Lingduhm/TI_motor_Gimbal_System/empty_motor_rebuild_divide_OK/keil/Objects/empty_LP_MSPM0G3507_nortos_keil.htm

# Static Call Graph for image .\Objects\empty_LP_MSPM0G3507_nortos_keil.axf

#<CALLGRAPH># ARM Linker, 6210000: Last Updated: Tue Mar 31 16:03:42 2026

### Maximum Stack Usage = 56 bytes + Unknown(Cycles, Untraceable Function Pointers)

### Call chain for Maximum Stack Depth:

Action_Straight ⇒ go_forward_b

### Mutually Recursive functions

- NMI_Handler ⇒ NMI_Handler
- HardFault_Handler ⇒ HardFault_Handler
- SVC_Handler ⇒ SVC_Handler
- PendSV_Handler ⇒ PendSV_Handler
- SysTick_Handler ⇒ SysTick_Handler

### Function Pointers

- ADC0_IRQHandler from startup_mspm0g350x_uvision.o(.text) referenced from startup_mspm0g350x_uvision.o(RESET)
- ADC1_IRQHandler from startup_mspm0g350x_uvision.o(.text) referenced from startup_mspm0g350x_uvision.o(RESET)
- AES_IRQHandler from startup_mspm0g350x_uvision.o(.text) referenced from startup_mspm0g350x_uvision.o(RESET)
- Action_Straight from sensor_rebuild_02.o(.text.Action_Straight) referenced from sensor_rebuild_02.o(.rodata.Car_FSM_Table)
- Action_TurnLeft_Brake from sensor_rebuild_02.o(.text.Action_TurnLeft_Brake) referenced from sensor_rebuild_02.o(.rodata.Car_FSM_Table)
- Action_TurnLeft_Spin from sensor_rebuild_02.o(.text.Action_TurnLeft_Spin) referenced from sensor_rebuild_02.o(.rodata.Car_FSM_Table)
- Action_TurnLeft_Stop from sensor_rebuild_02.o(.text.Action_TurnLeft_Stop) referenced from sensor_rebuild_02.o(.rodata.Car_FSM_Table)
- CANFD0_IRQHandler from startup_mspm0g350x_uvision.o(.text) referenced from startup_mspm0g350x_uvision.o(RESET)
- DAC0_IRQHandler from startup_mspm0g350x_uvision.o(.text) referenced from startup_mspm0g350x_uvision.o(RESET)
- DMA_IRQHandler from startup_mspm0g350x_uvision.o(.text) referenced from startup_mspm0g350x_uvision.o(RESET)
- GROUP0_IRQHandler from startup_mspm0g350x_uvision.o(.text) referenced from startup_mspm0g350x_uvision.o(RESET)
- GROUP1_IRQHandler from startup_mspm0g350x_uvision.o(.text) referenced from startup_mspm0g350x_uvision.o(RESET)
- HardFault_Handler from startup_mspm0g350x_uvision.o(.text) referenced from startup_mspm0g350x_uvision.o(RESET)
- I2C0_IRQHandler from startup_mspm0g350x_uvision.o(.text) referenced from startup_mspm0g350x_uvision.o(RESET)
- I2C1_IRQHandler from startup_mspm0g350x_uvision.o(.text) referenced from startup_mspm0g350x_uvision.o(RESET)
- NMI_Handler from startup_mspm0g350x_uvision.o(.text) referenced from startup_mspm0g350x_uvision.o(RESET)
- PendSV_Handler from startup_mspm0g350x_uvision.o(.text) referenced from startup_mspm0g350x_uvision.o(RESET)
- RTC_IRQHandler from startup_mspm0g350x_uvision.o(.text) referenced from startup_mspm0g350x_uvision.o(RESET)
- Reset_Handler from startup_mspm0g350x_uvision.o(.text) referenced from startup_mspm0g350x_uvision.o(RESET)
- SPI0_IRQHandler from startup_mspm0g350x_uvision.o(.text) referenced from startup_mspm0g350x_uvision.o(RESET)
- SPI1_IRQHandler from startup_mspm0g350x_uvision.o(.text) referenced from startup_mspm0g350x_uvision.o(RESET)
- SVC_Handler from startup_mspm0g350x_uvision.o(.text) referenced from startup_mspm0g350x_uvision.o(RESET)
- SysTick_Handler from startup_mspm0g350x_uvision.o(.text) referenced from startup_mspm0g350x_uvision.o(RESET)
- TIMA0_IRQHandler from empty.o(.text.TIMA0_IRQHandler) referenced from startup_mspm0g350x_uvision.o(RESET)
- TIMA1_IRQHandler from startup_mspm0g350x_uvision.o(.text) referenced from startup_mspm0g350x_uvision.o(RESET)
- TIMG0_IRQHandler from startup_mspm0g350x_uvision.o(.text) referenced from startup_mspm0g350x_uvision.o(RESET)
- TIMG12_IRQHandler from startup_mspm0g350x_uvision.o(.text) referenced from startup_mspm0g350x_uvision.o(RESET)
- TIMG6_IRQHandler from startup_mspm0g350x_uvision.o(.text) referenced from startup_mspm0g350x_uvision.o(RESET)
- TIMG7_IRQHandler from startup_mspm0g350x_uvision.o(.text) referenced from startup_mspm0g350x_uvision.o(RESET)
- TIMG8_IRQHandler from startup_mspm0g350x_uvision.o(.text) referenced from startup_mspm0g350x_uvision.o(RESET)
- UART0_IRQHandler from empty.o(.text.UART0_IRQHandler) referenced from startup_mspm0g350x_uvision.o(RESET)
- UART1_IRQHandler from startup_mspm0g350x_uvision.o(.text) referenced from startup_mspm0g350x_uvision.o(RESET)
- UART2_IRQHandler from startup_mspm0g350x_uvision.o(.text) referenced from startup_mspm0g350x_uvision.o(RESET)
- UART3_IRQHandler from startup_mspm0g350x_uvision.o(.text) referenced from startup_mspm0g350x_uvision.o(RESET)
- __main from __main.o(!!!main) referenced from startup_mspm0g350x_uvision.o(.text)

### Global Symbols

__main (Thumb, 8 bytes, Stack size 0 bytes, __main.o(!!!main))

[Calls]

- >> __rt_entry
- >> __scatterload

[Address Reference Count : 1]

- startup_mspm0g350x_uvision.o(.text)

__scatterload (Thumb, 0 bytes, Stack size unknown bytes, __scatter.o(!!!scatter))

[Called By]

- >> __main

__scatterload_rt2 (Thumb, 74 bytes, Stack size unknown bytes, __scatter.o(!!!scatter), UNUSED)

[Calls]

- >> __rt_entry

__scatterload_rt2_thumb_only (Thumb, 0 bytes, Stack size unknown bytes, __scatter.o(!!!scatter), UNUSED)

__scatterload_loop (Thumb, 0 bytes, Stack size unknown bytes, __scatter.o(!!!scatter), UNUSED)

__scatterload_null (Thumb, 2 bytes, Stack size unknown bytes, __scatter.o(!!handler_null), UNUSED)

__scatterload_zeroinit (Thumb, 28 bytes, Stack size unknown bytes, __scatter_zi.o(!!handler_zi), UNUSED)

__rt_lib_init (Thumb, 0 bytes, Stack size unknown bytes, libinit.o(.ARM.Collect$$libinit$$00000000))

[Called By]

- >> __rt_entry_li

__rt_lib_init_alloca_1 (Thumb, 0 bytes, Stack size unknown bytes, libinit2.o(.ARM.Collect$$libinit$$00000030))

__rt_lib_init_argv_1 (Thumb, 0 bytes, Stack size unknown bytes, libinit2.o(.ARM.Collect$$libinit$$0000002E))

__rt_lib_init_atexit_1 (Thumb, 0 bytes, Stack size unknown bytes, libinit2.o(.ARM.Collect$$libinit$$0000001D))

__rt_lib_init_clock_1 (Thumb, 0 bytes, Stack size unknown bytes, libinit2.o(.ARM.Collect$$libinit$$00000023))

__rt_lib_init_cpp_1 (Thumb, 0 bytes, Stack size unknown bytes, libinit2.o(.ARM.Collect$$libinit$$00000034))

__rt_lib_init_exceptions_1 (Thumb, 0 bytes, Stack size unknown bytes, libinit2.o(.ARM.Collect$$libinit$$00000032))

__rt_lib_init_fp_1 (Thumb, 0 bytes, Stack size unknown bytes, libinit2.o(.ARM.Collect$$libinit$$00000002))

__rt_lib_init_fp_trap_1 (Thumb, 0 bytes, Stack size unknown bytes, libinit2.o(.ARM.Collect$$libinit$$00000021))

__rt_lib_init_getenv_1 (Thumb, 0 bytes, Stack size unknown bytes, libinit2.o(.ARM.Collect$$libinit$$00000025))

__rt_lib_init_heap_1 (Thumb, 0 bytes, Stack size unknown bytes, libinit2.o(.ARM.Collect$$libinit$$0000000C))

__rt_lib_init_lc_collate_1 (Thumb, 0 bytes, Stack size unknown bytes, libinit2.o(.ARM.Collect$$libinit$$00000013))

__rt_lib_init_lc_ctype_1 (Thumb, 0 bytes, Stack size unknown bytes, libinit2.o(.ARM.Collect$$libinit$$00000015))

__rt_lib_init_lc_monetary_1 (Thumb, 0 bytes, Stack size unknown bytes, libinit2.o(.ARM.Collect$$libinit$$00000017))

__rt_lib_init_lc_numeric_1 (Thumb, 0 bytes, Stack size unknown bytes, libinit2.o(.ARM.Collect$$libinit$$00000019))

__rt_lib_init_lc_time_1 (Thumb, 0 bytes, Stack size unknown bytes, libinit2.o(.ARM.Collect$$libinit$$0000001B))

__rt_lib_init_preinit_1 (Thumb, 0 bytes, Stack size unknown bytes, libinit2.o(.ARM.Collect$$libinit$$00000006))

__rt_lib_init_rand_1 (Thumb, 0 bytes, Stack size unknown bytes, libinit2.o(.ARM.Collect$$libinit$$00000010))

__rt_lib_init_relocate_pie_1 (Thumb, 0 bytes, Stack size unknown bytes, libinit2.o(.ARM.Collect$$libinit$$00000004))

__rt_lib_init_return (Thumb, 0 bytes, Stack size unknown bytes, libinit2.o(.ARM.Collect$$libinit$$00000035))

__rt_lib_init_signal_1 (Thumb, 0 bytes, Stack size unknown bytes, libinit2.o(.ARM.Collect$$libinit$$0000001F))

__rt_lib_init_stdio_1 (Thumb, 0 bytes, Stack size unknown bytes, libinit2.o(.ARM.Collect$$libinit$$00000027))

__rt_lib_init_user_alloc_1 (Thumb, 0 bytes, Stack size unknown bytes, libinit2.o(.ARM.Collect$$libinit$$0000000E))

__rt_lib_shutdown (Thumb, 0 bytes, Stack size unknown bytes, libshutdown.o(.ARM.Collect$$libshutdown$$00000000))

[Called By]

- >> __rt_exit_ls

__rt_lib_shutdown_cpp_1 (Thumb, 0 bytes, Stack size unknown bytes, libshutdown2.o(.ARM.Collect$$libshutdown$$00000002))

__rt_lib_shutdown_fp_trap_1 (Thumb, 0 bytes, Stack size unknown bytes, libshutdown2.o(.ARM.Collect$$libshutdown$$00000007))

__rt_lib_shutdown_heap_1 (Thumb, 0 bytes, Stack size unknown bytes, libshutdown2.o(.ARM.Collect$$libshutdown$$0000000F))

__rt_lib_shutdown_return (Thumb, 0 bytes, Stack size unknown bytes, libshutdown2.o(.ARM.Collect$$libshutdown$$00000010))

__rt_lib_shutdown_signal_1 (Thumb, 0 bytes, Stack size unknown bytes, libshutdown2.o(.ARM.Collect$$libshutdown$$0000000A))

__rt_lib_shutdown_stdio_1 (Thumb, 0 bytes, Stack size unknown bytes, libshutdown2.o(.ARM.Collect$$libshutdown$$00000004))

__rt_lib_shutdown_user_alloc_1 (Thumb, 0 bytes, Stack size unknown bytes, libshutdown2.o(.ARM.Collect$$libshutdown$$0000000C))

__rt_entry (Thumb, 0 bytes, Stack size unknown bytes, __rtentry.o(.ARM.Collect$$rtentry$$00000000))

[Called By]

- >> __main
- >> __scatterload_rt2

__rt_entry_presh_1 (Thumb, 0 bytes, Stack size unknown bytes, __rtentry2.o(.ARM.Collect$$rtentry$$00000002))

__rt_entry_sh (Thumb, 0 bytes, Stack size unknown bytes, __rtentry4.o(.ARM.Collect$$rtentry$$00000004))

[Stack]

- Max Depth = 8 + Unknown Stack Size
- Call Chain = __rt_entry_sh ⇒ __user_setup_stackheap

[Calls]

- >> __user_setup_stackheap

__rt_entry_li (Thumb, 0 bytes, Stack size unknown bytes, __rtentry2.o(.ARM.Collect$$rtentry$$0000000A))

[Calls]

- >> __rt_lib_init

__rt_entry_postsh_1 (Thumb, 0 bytes, Stack size unknown bytes, __rtentry2.o(.ARM.Collect$$rtentry$$00000009))

__rt_entry_main (Thumb, 0 bytes, Stack size unknown bytes, __rtentry2.o(.ARM.Collect$$rtentry$$0000000D))

[Stack]

- Max Depth = 52 + Unknown Stack Size
- Call Chain = __rt_entry_main ⇒ main ⇒ SYSCFG_DL_init ⇒ SYSCFG_DL_Motor_B_init ⇒ DL_Timer_initFourCCPWMMode

[Calls]

- >> main
- >> exit

__rt_entry_postli_1 (Thumb, 0 bytes, Stack size unknown bytes, __rtentry2.o(.ARM.Collect$$rtentry$$0000000C))

__rt_exit (Thumb, 0 bytes, Stack size unknown bytes, rtexit.o(.ARM.Collect$$rtexit$$00000000))

[Called By]

- >> exit

__rt_exit_ls (Thumb, 0 bytes, Stack size unknown bytes, rtexit2.o(.ARM.Collect$$rtexit$$00000003))

[Calls]

- >> __rt_lib_shutdown

__rt_exit_prels_1 (Thumb, 0 bytes, Stack size unknown bytes, rtexit2.o(.ARM.Collect$$rtexit$$00000002))

__rt_exit_exit (Thumb, 0 bytes, Stack size unknown bytes, rtexit2.o(.ARM.Collect$$rtexit$$00000004))

[Calls]

- >> _sys_exit

Reset_Handler (Thumb, 4 bytes, Stack size 0 bytes, startup_mspm0g350x_uvision.o(.text))
[Address Reference Count : 1]

- startup_mspm0g350x_uvision.o(RESET)

NMI_Handler (Thumb, 2 bytes, Stack size 0 bytes, startup_mspm0g350x_uvision.o(.text))

[Calls]

- >> NMI_Handler

[Called By]

- >> NMI_Handler

[Address Reference Count : 1]

- startup_mspm0g350x_uvision.o(RESET)

HardFault_Handler (Thumb, 2 bytes, Stack size 0 bytes, startup_mspm0g350x_uvision.o(.text))

[Calls]

- >> HardFault_Handler

[Called By]

- >> HardFault_Handler

[Address Reference Count : 1]

- startup_mspm0g350x_uvision.o(RESET)

SVC_Handler (Thumb, 2 bytes, Stack size 0 bytes, startup_mspm0g350x_uvision.o(.text))

[Calls]

- >> SVC_Handler

[Called By]

- >> SVC_Handler

[Address Reference Count : 1]

- startup_mspm0g350x_uvision.o(RESET)

PendSV_Handler (Thumb, 2 bytes, Stack size 0 bytes, startup_mspm0g350x_uvision.o(.text))

[Calls]

- >> PendSV_Handler

[Called By]

- >> PendSV_Handler

[Address Reference Count : 1]

- startup_mspm0g350x_uvision.o(RESET)

SysTick_Handler (Thumb, 2 bytes, Stack size 0 bytes, startup_mspm0g350x_uvision.o(.text))

[Calls]

- >> SysTick_Handler

[Called By]

- >> SysTick_Handler

[Address Reference Count : 1]

- startup_mspm0g350x_uvision.o(RESET)

ADC0_IRQHandler (Thumb, 0 bytes, Stack size 0 bytes, startup_mspm0g350x_uvision.o(.text))
[Address Reference Count : 1]

- startup_mspm0g350x_uvision.o(RESET)

ADC1_IRQHandler (Thumb, 0 bytes, Stack size 0 bytes, startup_mspm0g350x_uvision.o(.text))
[Address Reference Count : 1]

- startup_mspm0g350x_uvision.o(RESET)

AES_IRQHandler (Thumb, 0 bytes, Stack size 0 bytes, startup_mspm0g350x_uvision.o(.text))
[Address Reference Count : 1]

- startup_mspm0g350x_uvision.o(RESET)

CANFD0_IRQHandler (Thumb, 0 bytes, Stack size 0 bytes, startup_mspm0g350x_uvision.o(.text))
[Address Reference Count : 1]

- startup_mspm0g350x_uvision.o(RESET)

DAC0_IRQHandler (Thumb, 0 bytes, Stack size 0 bytes, startup_mspm0g350x_uvision.o(.text))
[Address Reference Count : 1]

- startup_mspm0g350x_uvision.o(RESET)

DMA_IRQHandler (Thumb, 0 bytes, Stack size 0 bytes, startup_mspm0g350x_uvision.o(.text))
[Address Reference Count : 1]

- startup_mspm0g350x_uvision.o(RESET)

Default_Handler (Thumb, 2 bytes, Stack size 0 bytes, startup_mspm0g350x_uvision.o(.text), UNUSED)

[Calls]

- >> Default_Handler

[Called By]

- >> Default_Handler

GROUP0_IRQHandler (Thumb, 0 bytes, Stack size 0 bytes, startup_mspm0g350x_uvision.o(.text))
[Address Reference Count : 1]

- startup_mspm0g350x_uvision.o(RESET)

GROUP1_IRQHandler (Thumb, 0 bytes, Stack size 0 bytes, startup_mspm0g350x_uvision.o(.text))
[Address Reference Count : 1]

- startup_mspm0g350x_uvision.o(RESET)

I2C0_IRQHandler (Thumb, 0 bytes, Stack size 0 bytes, startup_mspm0g350x_uvision.o(.text))
[Address Reference Count : 1]

- startup_mspm0g350x_uvision.o(RESET)

I2C1_IRQHandler (Thumb, 0 bytes, Stack size 0 bytes, startup_mspm0g350x_uvision.o(.text))
[Address Reference Count : 1]

- startup_mspm0g350x_uvision.o(RESET)

RTC_IRQHandler (Thumb, 0 bytes, Stack size 0 bytes, startup_mspm0g350x_uvision.o(.text))
[Address Reference Count : 1]

- startup_mspm0g350x_uvision.o(RESET)

SPI0_IRQHandler (Thumb, 0 bytes, Stack size 0 bytes, startup_mspm0g350x_uvision.o(.text))
[Address Reference Count : 1]

- startup_mspm0g350x_uvision.o(RESET)

SPI1_IRQHandler (Thumb, 0 bytes, Stack size 0 bytes, startup_mspm0g350x_uvision.o(.text))
[Address Reference Count : 1]

- startup_mspm0g350x_uvision.o(RESET)

TIMA1_IRQHandler (Thumb, 0 bytes, Stack size 0 bytes, startup_mspm0g350x_uvision.o(.text))
[Address Reference Count : 1]

- startup_mspm0g350x_uvision.o(RESET)

TIMG0_IRQHandler (Thumb, 0 bytes, Stack size 0 bytes, startup_mspm0g350x_uvision.o(.text))
[Address Reference Count : 1]

- startup_mspm0g350x_uvision.o(RESET)

TIMG12_IRQHandler (Thumb, 0 bytes, Stack size 0 bytes, startup_mspm0g350x_uvision.o(.text))
[Address Reference Count : 1]

- startup_mspm0g350x_uvision.o(RESET)

TIMG6_IRQHandler (Thumb, 0 bytes, Stack size 0 bytes, startup_mspm0g350x_uvision.o(.text))
[Address Reference Count : 1]

- startup_mspm0g350x_uvision.o(RESET)

TIMG7_IRQHandler (Thumb, 0 bytes, Stack size 0 bytes, startup_mspm0g350x_uvision.o(.text))
[Address Reference Count : 1]

- startup_mspm0g350x_uvision.o(RESET)

TIMG8_IRQHandler (Thumb, 0 bytes, Stack size 0 bytes, startup_mspm0g350x_uvision.o(.text))
[Address Reference Count : 1]

- startup_mspm0g350x_uvision.o(RESET)

UART1_IRQHandler (Thumb, 0 bytes, Stack size 0 bytes, startup_mspm0g350x_uvision.o(.text))
[Address Reference Count : 1]

- startup_mspm0g350x_uvision.o(RESET)

UART2_IRQHandler (Thumb, 0 bytes, Stack size 0 bytes, startup_mspm0g350x_uvision.o(.text))
[Address Reference Count : 1]

- startup_mspm0g350x_uvision.o(RESET)

UART3_IRQHandler (Thumb, 0 bytes, Stack size 0 bytes, startup_mspm0g350x_uvision.o(.text))
[Address Reference Count : 1]

- startup_mspm0g350x_uvision.o(RESET)

__user_initial_stackheap (Thumb, 10 bytes, Stack size 0 bytes, startup_mspm0g350x_uvision.o(.text))

[Called By]

- >> __user_setup_stackheap

_memset_w (Thumb, 26 bytes, Stack size 0 bytes, rt_memclr.o(.text), UNUSED)

[Called By]

- >> __rt_memclr_w
- >> _memset

_memset (Thumb, 30 bytes, Stack size 0 bytes, rt_memclr.o(.text), UNUSED)

[Calls]

- >> _memset_w

[Called By]

- >> __aeabi_memclr

__aeabi_memclr (Thumb, 4 bytes, Stack size 0 bytes, rt_memclr.o(.text), UNUSED)

[Calls]

- >> _memset

__rt_memclr (Thumb, 0 bytes, Stack size 0 bytes, rt_memclr.o(.text), UNUSED)

__aeabi_memclr4 (Thumb, 0 bytes, Stack size 0 bytes, rt_memclr.o(.text))

[Called By]

- >> car_init

__aeabi_memclr8 (Thumb, 0 bytes, Stack size 0 bytes, rt_memclr.o(.text), UNUSED)

__rt_memclr_w (Thumb, 4 bytes, Stack size 0 bytes, rt_memclr.o(.text), UNUSED)

[Calls]

- >> _memset_w

__use_two_region_memory (Thumb, 2 bytes, Stack size 0 bytes, heapauxi.o(.text), UNUSED)

__rt_heap_escrow (Thumb, 2 bytes, Stack size 0 bytes, heapauxi.o(.text), UNUSED)

__rt_heap_expand (Thumb, 2 bytes, Stack size 0 bytes, heapauxi.o(.text), UNUSED)

__aeabi_f2iz (Thumb, 0 bytes, Stack size 8 bytes, ffixi.o(.text))

[Stack]

- Max Depth = 8
- Call Chain = __aeabi_f2iz

[Called By]

- >> Action_TurnLeft_Brake
- >> Action_Straight

_ffix (Thumb, 76 bytes, Stack size 8 bytes, ffixi.o(.text), UNUSED)

__fpl_fcmp_InfNaN (Thumb, 96 bytes, Stack size 8 bytes, fcmpin.o(.text), UNUSED)

[Calls]

- >> __fpl_fcheck_NaN2
- >> __fpl_cmpreturn

[Called By]

- >> _fcmpge

__user_setup_stackheap (Thumb, 62 bytes, Stack size 8 bytes, sys_stackheap_outer.o(.text))

[Stack]

- Max Depth = 8
- Call Chain = __user_setup_stackheap

[Calls]

- >> __user_initial_stackheap
- >> __user_perproc_libspace

[Called By]

- >> __rt_entry_sh

exit (Thumb, 16 bytes, Stack size 8 bytes, exit.o(.text))

[Stack]

- Max Depth = 8 + Unknown Stack Size
- Call Chain = exit

[Calls]

- >> _call_atexit_fns (Weak Reference)
- >> __rt_exit

[Called By]

- >> __rt_entry_main

__fpl_cmpreturn (Thumb, 46 bytes, Stack size 0 bytes, cmpret.o(.text), UNUSED)

[Called By]

- >> __fpl_fcmp_InfNaN
- >> __fpl_return_NaN

__fpl_fcheck_NaN2 (Thumb, 10 bytes, Stack size 8 bytes, fnan2.o(.text), UNUSED)

[Calls]

- >> __fpl_return_NaN

[Called By]

- >> __fpl_fcmp_InfNaN

__user_libspace (Thumb, 8 bytes, Stack size 0 bytes, libspace.o(.text), UNUSED)

__user_perproc_libspace (Thumb, 0 bytes, Stack size 0 bytes, libspace.o(.text))

[Called By]

- >> __user_setup_stackheap

__user_perthread_libspace (Thumb, 0 bytes, Stack size 0 bytes, libspace.o(.text), UNUSED)

__fpl_return_NaN (Thumb, 94 bytes, Stack size 8 bytes, retnan.o(.text), UNUSED)

[Calls]

- >> __fpl_cmpreturn

[Called By]

- >> __fpl_fcheck_NaN2

_sys_exit (Thumb, 8 bytes, Stack size 0 bytes, sys_exit.o(.text))

[Called By]

- >> __rt_exit_exit

__I$use$semihosting (Thumb, 0 bytes, Stack size 0 bytes, use_no_semi.o(.text), UNUSED)

__use_no_semihosting_swi (Thumb, 2 bytes, Stack size 0 bytes, use_no_semi.o(.text), UNUSED)

__semihosting_library_function (Thumb, 0 bytes, Stack size unknown bytes, indicate_semi.o(.text), UNUSED)

Action_Straight (Thumb, 452 bytes, Stack size 40 bytes, sensor_rebuild_02.o(.text.Action_Straight))

[Stack]

- Max Depth = 56
- Call Chain = Action_Straight ⇒ go_forward_b

[Calls]

- >> go_forward_b
- >> go_forward_a
- >> __aeabi_fmul
- >> __aeabi_f2iz
- >> __aeabi_fcmpgt
- >> __aeabi_fcmpge
- >> __aeabi_fsub
- >> __aeabi_fadd

[Address Reference Count : 1]

- sensor_rebuild_02.o(.rodata.Car_FSM_Table)

Action_TurnLeft_Brake (Thumb, 52 bytes, Stack size 8 bytes, sensor_rebuild_02.o(.text.Action_TurnLeft_Brake))

[Stack]

- Max Depth = 24
- Call Chain = Action_TurnLeft_Brake ⇒ go_backward_b

[Calls]

- >> go_backward_b
- >> go_backward_a
- >> __aeabi_f2iz

[Address Reference Count : 1]

- sensor_rebuild_02.o(.rodata.Car_FSM_Table)

Action_TurnLeft_Spin (Thumb, 72 bytes, Stack size 16 bytes, sensor_rebuild_02.o(.text.Action_TurnLeft_Spin))

[Stack]

- Max Depth = 32
- Call Chain = Action_TurnLeft_Spin ⇒ go_forward_b

[Calls]

- >> go_forward_b
- >> go_forward_a

[Address Reference Count : 1]

- sensor_rebuild_02.o(.rodata.Car_FSM_Table)

Action_TurnLeft_Stop (Thumb, 72 bytes, Stack size 8 bytes, sensor_rebuild_02.o(.text.Action_TurnLeft_Stop))

[Stack]

- Max Depth = 24
- Call Chain = Action_TurnLeft_Stop ⇒ go_backward_a

[Calls]

- >> go_backward_a

[Address Reference Count : 1]

- sensor_rebuild_02.o(.rodata.Car_FSM_Table)

DL_Common_delayCycles (Thumb, 10 bytes, Stack size 0 bytes, dl_common.o(.text.DL_Common_delayCycles))

[Called By]

- >> SYSCFG_DL_initPower
- >> main

DL_SPI_init (Thumb, 68 bytes, Stack size 16 bytes, dl_spi.o(.text.DL_SPI_init))

[Stack]

- Max Depth = 16
- Call Chain = DL_SPI_init

[Called By]

- >> SYSCFG_DL_SPI_init

DL_SPI_setClockConfig (Thumb, 18 bytes, Stack size 8 bytes, dl_spi.o(.text.DL_SPI_setClockConfig))

[Stack]

- Max Depth = 8
- Call Chain = DL_SPI_setClockConfig

[Called By]

- >> SYSCFG_DL_SPI_init

DL_Timer_initFourCCPWMMode (Thumb, 264 bytes, Stack size 20 bytes, dl_timer.o(.text.DL_Timer_initFourCCPWMMode))

[Stack]

- Max Depth = 20
- Call Chain = DL_Timer_initFourCCPWMMode

[Called By]

- >> SYSCFG_DL_Motor_B_init
- >> SYSCFG_DL_Motor_A_init

DL_Timer_initTimerMode (Thumb, 240 bytes, Stack size 16 bytes, dl_timer.o(.text.DL_Timer_initTimerMode))

[Stack]

- Max Depth = 16
- Call Chain = DL_Timer_initTimerMode

[Called By]

- >> SYSCFG_DL_TIMER_0_init

DL_Timer_setCaptCompUpdateMethod (Thumb, 28 bytes, Stack size 8 bytes, dl_timer.o(.text.DL_Timer_setCaptCompUpdateMethod))

[Stack]

- Max Depth = 8
- Call Chain = DL_Timer_setCaptCompUpdateMethod

[Called By]

- >> SYSCFG_DL_Motor_B_init
- >> SYSCFG_DL_Motor_A_init

DL_Timer_setCaptureCompareOutCtl (Thumb, 24 bytes, Stack size 8 bytes, dl_timer.o(.text.DL_Timer_setCaptureCompareOutCtl))

[Stack]

- Max Depth = 8
- Call Chain = DL_Timer_setCaptureCompareOutCtl

[Called By]

- >> SYSCFG_DL_Motor_B_init
- >> SYSCFG_DL_Motor_A_init

DL_Timer_setCaptureCompareValue (Thumb, 16 bytes, Stack size 0 bytes, dl_timer.o(.text.DL_Timer_setCaptureCompareValue))

[Called By]

- >> go_stop
- >> go_backward_b
- >> go_forward_b
- >> go_backward_a
- >> go_forward_a
- >> SYSCFG_DL_Motor_B_init
- >> SYSCFG_DL_Motor_A_init

DL_Timer_setClockConfig (Thumb, 28 bytes, Stack size 8 bytes, dl_timer.o(.text.DL_Timer_setClockConfig))

[Stack]

- Max Depth = 8
- Call Chain = DL_Timer_setClockConfig

[Called By]

- >> SYSCFG_DL_TIMER_0_init
- >> SYSCFG_DL_Motor_B_init
- >> SYSCFG_DL_Motor_A_init

DL_UART_init (Thumb, 72 bytes, Stack size 16 bytes, dl_uart.o(.text.DL_UART_init))

[Stack]

- Max Depth = 16
- Call Chain = DL_UART_init

[Called By]

- >> SYSCFG_DL_UART_0_init

DL_UART_setClockConfig (Thumb, 18 bytes, Stack size 8 bytes, dl_uart.o(.text.DL_UART_setClockConfig))

[Stack]

- Max Depth = 8
- Call Chain = DL_UART_setClockConfig

[Called By]

- >> SYSCFG_DL_UART_0_init

SYSCFG_DL_GPIO_init (Thumb, 112 bytes, Stack size 16 bytes, ti_msp_dl_config.o(.text.SYSCFG_DL_GPIO_init))

[Stack]

- Max Depth = 16
- Call Chain = SYSCFG_DL_GPIO_init

[Called By]

- >> SYSCFG_DL_init

SYSCFG_DL_Motor_A_init (Thumb, 108 bytes, Stack size 24 bytes, ti_msp_dl_config.o(.text.SYSCFG_DL_Motor_A_init))

[Stack]

- Max Depth = 44
- Call Chain = SYSCFG_DL_Motor_A_init ⇒ DL_Timer_initFourCCPWMMode

[Calls]

- >> DL_Timer_setCaptureCompareValue
- >> DL_Timer_setCaptCompUpdateMethod
- >> DL_Timer_setCaptureCompareOutCtl
- >> DL_Timer_initFourCCPWMMode
- >> DL_Timer_setClockConfig

[Called By]

- >> SYSCFG_DL_init

SYSCFG_DL_Motor_B_init (Thumb, 108 bytes, Stack size 24 bytes, ti_msp_dl_config.o(.text.SYSCFG_DL_Motor_B_init))

[Stack]

- Max Depth = 44
- Call Chain = SYSCFG_DL_Motor_B_init ⇒ DL_Timer_initFourCCPWMMode

[Calls]

- >> DL_Timer_setCaptureCompareValue
- >> DL_Timer_setCaptCompUpdateMethod
- >> DL_Timer_setCaptureCompareOutCtl
- >> DL_Timer_initFourCCPWMMode
- >> DL_Timer_setClockConfig

[Called By]

- >> SYSCFG_DL_init

SYSCFG_DL_SPI_init (Thumb, 52 bytes, Stack size 8 bytes, ti_msp_dl_config.o(.text.SYSCFG_DL_SPI_init))

[Stack]

- Max Depth = 24
- Call Chain = SYSCFG_DL_SPI_init ⇒ DL_SPI_init

[Calls]

- >> DL_SPI_init
- >> DL_SPI_setClockConfig

[Called By]

- >> SYSCFG_DL_init

SYSCFG_DL_SYSCTL_init (Thumb, 52 bytes, Stack size 0 bytes, ti_msp_dl_config.o(.text.SYSCFG_DL_SYSCTL_init))

[Called By]

- >> SYSCFG_DL_init

SYSCFG_DL_TIMER_0_init (Thumb, 36 bytes, Stack size 8 bytes, ti_msp_dl_config.o(.text.SYSCFG_DL_TIMER_0_init))

[Stack]

- Max Depth = 24
- Call Chain = SYSCFG_DL_TIMER_0_init ⇒ DL_Timer_initTimerMode

[Calls]

- >> DL_Timer_initTimerMode
- >> DL_Timer_setClockConfig

[Called By]

- >> SYSCFG_DL_init

SYSCFG_DL_UART_0_init (Thumb, 88 bytes, Stack size 8 bytes, ti_msp_dl_config.o(.text.SYSCFG_DL_UART_0_init))

[Stack]

- Max Depth = 24
- Call Chain = SYSCFG_DL_UART_0_init ⇒ DL_UART_init

[Calls]

- >> DL_UART_init
- >> DL_UART_setClockConfig

[Called By]

- >> SYSCFG_DL_init

SYSCFG_DL_init (Thumb, 60 bytes, Stack size 8 bytes, ti_msp_dl_config.o(.text.SYSCFG_DL_init))

[Stack]

- Max Depth = 52
- Call Chain = SYSCFG_DL_init ⇒ SYSCFG_DL_Motor_B_init ⇒ DL_Timer_initFourCCPWMMode

[Calls]

- >> SYSCFG_DL_SPI_init
- >> SYSCFG_DL_UART_0_init
- >> SYSCFG_DL_TIMER_0_init
- >> SYSCFG_DL_Motor_B_init
- >> SYSCFG_DL_Motor_A_init
- >> SYSCFG_DL_SYSCTL_init
- >> SYSCFG_DL_GPIO_init
- >> SYSCFG_DL_initPower

[Called By]

- >> main

SYSCFG_DL_initPower (Thumb, 60 bytes, Stack size 24 bytes, ti_msp_dl_config.o(.text.SYSCFG_DL_initPower))

[Stack]

- Max Depth = 24
- Call Chain = SYSCFG_DL_initPower

[Calls]

- >> DL_Common_delayCycles

[Called By]

- >> SYSCFG_DL_init

TIMA0_IRQHandler (Thumb, 36 bytes, Stack size 8 bytes, empty.o(.text.TIMA0_IRQHandler))

[Stack]

- Max Depth = 8
- Call Chain = TIMA0_IRQHandler

[Calls]

- >> read_key

[Address Reference Count : 1]

- startup_mspm0g350x_uvision.o(RESET)

TaskManager_Init (Thumb, 16 bytes, Stack size 0 bytes, task.o(.text.TaskManager_Init))

[Called By]

- >> main

TaskManager_Update (Thumb, 240 bytes, Stack size 8 bytes, task.o(.text.TaskManager_Update))

[Stack]

- Max Depth = 40
- Call Chain = TaskManager_Update ⇒ sensor_read

[Calls]

- >> sensor_read
- >> sensor_pid
- >> go_stop

[Called By]

- >> main

UART0_IRQHandler (Thumb, 48 bytes, Stack size 0 bytes, empty.o(.text.UART0_IRQHandler))
[Address Reference Count : 1]

- startup_mspm0g350x_uvision.o(RESET)

car_init (Thumb, 80 bytes, Stack size 24 bytes, sensor_rebuild_02.o(.text.car_init))

[Stack]

- Max Depth = 24
- Call Chain = car_init

[Calls]

- >> __aeabi_memclr4

[Called By]

- >> main

go_backward_a (Thumb, 56 bytes, Stack size 16 bytes, motor.o(.text.go_backward_a))

[Stack]

- Max Depth = 16
- Call Chain = go_backward_a

[Calls]

- >> DL_Timer_setCaptureCompareValue

[Called By]

- >> Action_TurnLeft_Stop
- >> Action_TurnLeft_Brake

go_backward_b (Thumb, 56 bytes, Stack size 16 bytes, motor.o(.text.go_backward_b))

[Stack]

- Max Depth = 16
- Call Chain = go_backward_b

[Calls]

- >> DL_Timer_setCaptureCompareValue

[Called By]

- >> Action_TurnLeft_Brake

go_forward_a (Thumb, 56 bytes, Stack size 16 bytes, motor.o(.text.go_forward_a))

[Stack]

- Max Depth = 16
- Call Chain = go_forward_a

[Calls]

- >> DL_Timer_setCaptureCompareValue

[Called By]

- >> Action_TurnLeft_Spin
- >> Action_Straight

go_forward_b (Thumb, 56 bytes, Stack size 16 bytes, motor.o(.text.go_forward_b))

[Stack]

- Max Depth = 16
- Call Chain = go_forward_b

[Calls]

- >> DL_Timer_setCaptureCompareValue

[Called By]

- >> Action_TurnLeft_Spin
- >> Action_Straight

go_stop (Thumb, 52 bytes, Stack size 16 bytes, motor.o(.text.go_stop))

[Stack]

- Max Depth = 16
- Call Chain = go_stop

[Calls]

- >> DL_Timer_setCaptureCompareValue

[Called By]

- >> TaskManager_Update

main (Thumb, 44 bytes, Stack size 0 bytes, empty.o(.text.main))

[Stack]

- Max Depth = 52
- Call Chain = main ⇒ SYSCFG_DL_init ⇒ SYSCFG_DL_Motor_B_init ⇒ DL_Timer_initFourCCPWMMode

[Calls]

- >> TaskManager_Update
- >> car_init
- >> TaskManager_Init
- >> DL_Common_delayCycles
- >> SYSCFG_DL_init

[Called By]

- >> __rt_entry_main

read_key (Thumb, 56 bytes, Stack size 0 bytes, key.o(.text.read_key))

[Called By]

- >> TIMA0_IRQHandler

sensor_pid (Thumb, 40 bytes, Stack size 8 bytes, sensor_rebuild_02.o(.text.sensor_pid))

[Stack]

- Max Depth = 8
- Call Chain = sensor_pid

[Called By]

- >> TaskManager_Update

sensor_read (Thumb, 284 bytes, Stack size 32 bytes, sensor_rebuild_02.o(.text.sensor_read))

[Stack]

- Max Depth = 32
- Call Chain = sensor_read

[Called By]

- >> TaskManager_Update

__aeabi_fcmpge (Thumb, 0 bytes, Stack size 8 bytes, fcmp.o(i._fgeq))

[Stack]

- Max Depth = 8
- Call Chain = __aeabi_fcmpge

[Called By]

- >> Action_Straight

_fgeq (Thumb, 22 bytes, Stack size 8 bytes, fcmp.o(i._fgeq), UNUSED)

[Calls]

- >> _fcmpge

__aeabi_fcmpgt (Thumb, 0 bytes, Stack size 8 bytes, fcmp.o(i._fgr))

[Stack]

- Max Depth = 8
- Call Chain = __aeabi_fcmpgt

[Called By]

- >> Action_Straight

_fgr (Thumb, 22 bytes, Stack size 8 bytes, fcmp.o(i._fgr), UNUSED)

[Calls]

- >> _fcmpge

__aeabi_fadd (Thumb, 0 bytes, Stack size 16 bytes, faddsub.o(x$fpl$fadd))

[Stack]

- Max Depth = 16
- Call Chain = __aeabi_fadd

[Called By]

- >> Action_Straight

_fadd (Thumb, 134 bytes, Stack size 16 bytes, faddsub.o(x$fpl$fadd), UNUSED)

[Calls]

- >> _fsub1

_fcmpge (Thumb, 78 bytes, Stack size 8 bytes, fgef.o(x$fpl$fgeqf), UNUSED)

[Calls]

- >> __fpl_fcmp_InfNaN

[Called By]

- >> _fgr
- >> _fgeq

__aeabi_fmul (Thumb, 0 bytes, Stack size 16 bytes, fmul.o(x$fpl$fmul))

[Stack]

- Max Depth = 16
- Call Chain = __aeabi_fmul

[Called By]

- >> Action_Straight

_fmul (Thumb, 172 bytes, Stack size 16 bytes, fmul.o(x$fpl$fmul), UNUSED)

__aeabi_fsub (Thumb, 0 bytes, Stack size 16 bytes, faddsub.o(x$fpl$fsub))

[Stack]

- Max Depth = 16
- Call Chain = __aeabi_fsub

[Called By]

- >> Action_Straight

_fsub (Thumb, 204 bytes, Stack size 16 bytes, faddsub.o(x$fpl$fsub), UNUSED)

[Calls]

- >> _fadd1

### Local Symbols

_fadd1 (Thumb, 0 bytes, Stack size unknown bytes, faddsub.o(x$fpl$fadd), UNUSED)

[Called By]

- >> _fsub

_fsub1 (Thumb, 0 bytes, Stack size unknown bytes, faddsub.o(x$fpl$fsub), UNUSED)

[Called By]

- >> _fadd

### Undefined Global Symbols

_call_atexit_fns (ARM, 0 bytes, Stack size 0 bytes, UNDEFINED)

[Called By]

- >> exit
