Lingduhm/TI_motor_Gimbal_System/Gimbal/Core/Src/main.c

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
/* Includes ------------------------------------------------------------------*/
#include "main.h"
#include "tim.h"
#include "usart.h"
#include "gpio.h"

/* USER CODE BEGIN Includes */
#include "stdlib.h"
//#include "OLED.h"
#include "PWM.h"
#include "pid.h"
#include "chuanko.h"
#include "Servo.h"
#include "stdio.h"
#include "string.h"
#include "math.h"
/* USER CODE END Includes */


void SystemClock_Config(void);
/* USER CODE BEGIN 0 */
extern char RxBuffer[RX_BUFFER_SIZE]; 
extern volatile uint8_t RxIndex; 
extern uint8_t data_received;
extern uint16_t xx,yy;
extern float xxx,yyy;
extern uint8_t uart_rx_byte;
unsigned char flag=0;
unsigned char flag_3=0;
unsigned int first_down=2350;
unsigned int i=0;
unsigned int now_2;
unsigned int x_center=131;
float x_err;
void key_read()
{
	if(HAL_GPIO_ReadPin(GPIOA,GPIO_PIN_12)==GPIO_PIN_RESET)
	{
		flag=1;
	}
	else if(HAL_GPIO_ReadPin(GPIOB,GPIO_PIN_3)==GPIO_PIN_RESET)
	{
		flag=2;
	}
}
void Init_1()
{
	TIM2->CCR2 = first_down;
	TIM2->CCR3 = 1500;
}
void Init_2()
{
	TIM2->CCR2 = 500;
	TIM2->CCR3 = 1500;
}
/* USER CODE END 0 */

/**
  * @brief  The application entry point.
  * @retval int
  */
int main(void)
{

  /* MCU Configuration--------------------------------------------------------*/

  /* Reset of all peripherals, Initializes the Flash interface and the Systick. */
  HAL_Init();

  /* Configure the system clock */
  SystemClock_Config();

  /* Initialize all configured peripherals */
  MX_GPIO_Init();
  MX_TIM2_Init();
  MX_USART1_UART_Init();
  /* USER CODE BEGIN 2 */
//	OLED_Init();
	HAL_UART_Receive_IT(&huart1, &uart_rx_byte, 1);
	HAL_TIM_PWM_Start(&htim2,TIM_CHANNEL_2);
	HAL_TIM_PWM_Start(&htim2,TIM_CHANNEL_3);
	HAL_GPIO_WritePin(GPIOB,GPIO_PIN_12,GPIO_PIN_RESET);
	TIM2->CCR2 = 2350;
	TIM2->CCR3 = 1500;
////	Servo_SetAngle1(90);
//	TIM2->CCR3 = 1500;
  /* USER CODE END 2 */

  /* Infinite loop */
  /* USER CODE BEGIN WHILE */
  while (1)
  {
    /* USER CODE END WHILE */

    /* USER CODE BEGIN 3 */
	  pid_trans();
		key_read();
		if(flag==1)
		{
			Process_Received_Data();
			if(xxx != 0)
			{
				pid_S_X(xxx,x_center);
			}
	//		if(yy != 0)
	//		{
	//			pid_S_Y(yy,75);
	//		}
			x_err=xxx-x_center;
			if(fabs(x_err)<4)
			{
				HAL_GPIO_WritePin(GPIOB,GPIO_PIN_12,GPIO_PIN_SET);
			}
//			OLED_ShowNum(3, 1, xx, 5);
//			OLED_ShowNum(4, 1, yy, 5);
		}
		else if(flag==2)
		{
			Process_Received_Data();
			x_center=138;
			for(;i<1850;i++)
			{
			  TIM2->CCR2=2350-i;
				now_2=2350-i;
				Process_Received_Data();
				HAL_Delay(1);
				if(xxx != 0)
				{
					i=1851;
					flag_3=1;
//					pid_S_X(xxx,x_center);
				}
			}
		//		if(yy != 0)
		//		{
		//			pid_S_Y(yy,75);
		//		}
				if(xxx != 0)
				{
					pid_S_X(xxx,x_center);
				}
				x_err=xxx-x_center;
				if(fabs(x_err)<5.0f)
				{
					HAL_GPIO_WritePin(GPIOB,GPIO_PIN_12,GPIO_PIN_SET);
				}
				else
				{
					HAL_GPIO_WritePin(GPIOB,GPIO_PIN_12,GPIO_PIN_RESET);
				}
//				OLED_ShowNum(3, 1, xx, 5);
//				OLED_ShowNum(4, 1, yy, 5);
		}
	}
  /* USER CODE END 3 */
}

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
