Lingduhm/TI_motor_Gimbal_System/Gimbal/Core/Inc/main.h

#define KEY_Pin GPIO_PIN_12
#define KEY_GPIO_Port GPIOA
#define KEY2_Pin GPIO_PIN_3
#define KEY2_GPIO_Port GPIOB
#define SCL_Pin GPIO_PIN_8
#define SCL_GPIO_Port GPIOB
#define SDA_Pin GPIO_PIN_9
#define SDA_GPIO_Port GPIOB
