Lingduhm/TI_motor_Gimbal_System/empty_motor_rebuild_divide_OK/sensor.c

/*
 * 循迹PID控制 - 改进版 (增加积分分离和微分滤波)
 * 
 * 传感器布局：L2  L1  M0  R1  R2 (L2/R2专门检测直角弯)
 * 直线跟踪：只使用L1、M0、R1三个中间传感器
 * 转弯检测：L2检测到左转弯，R2检测到右转弯
 * 
 * 状态机：
 * - 0: 直线跟踪模式
 * - 1: 左转模式  
 * - 2: 右转模式
 * 
 * 转弯改进：
 * - 原地转弯：双轮最大速度反向运动
 * - 智能退出：转弯200周期后检测M0，连续3次检测到黑线立即停止
 * - 冷却机制：转弯后2s内不能再次转弯
 * - 分阶段转弯：停止-转弯-停止 三阶段控制
 * - 时间补偿：根据转弯前偏差自适应调整转弯时间
 * 
 * 新增PID改进：
 * - 积分分离：大偏差时停止积分累加
 * - 微分滤波：减少微分项噪声
 */

#include "sensor.h"

// 传感器读取宏定义
#define L2  (DL_GPIO_readPins(L2_PORT, L2_PIN_27_PIN) == 0)
#define L1  (DL_GPIO_readPins(L1_PORT, L1_PIN_23_PIN) == 0)
#define M0  (DL_GPIO_readPins(M0_PORT, M0_PIN_12_PIN) == 0)
#define R1  (DL_GPIO_readPins(R1_PORT, R1_PIN_8_PIN) == 0)
#define R2  (DL_GPIO_readPins(R2_PORT, R2_PIN_6_PIN) == 0)

// PID参数
float Kp_sensor = 2.5;     // 比例系数
float Ki_sensor = 0.08;    // 积分系数
float Kd_sensor = 0.4;     // 微分系数

// *** 新增：积分分离和微分滤波参数 ***
float integral_separate_threshold = 15.0;  // 积分分离阈值
float diff_filter_alpha = 0.7;             // 微分滤波系数 (0-1, 越小滤波越强)

// PID相关变量
float sensor_bias = 0;         // 当前偏差
float sensor_bias_last = 0;    // 上次偏差
float working_bias = 0;
float I = 0;                   // 积分项
float left_v = 0;              // 左轮速度
float right_v = 0;             // 右轮速度
float v_base = 41;             // 基础速度

// *** 新增：微分滤波相关变量 ***
float diff_raw = 0;            // 原始微分值
float diff_filtered = 0;       // 滤波后的微分值

// 死区和平滑控制参数
float deadzone = 5.0;          // 死区大小
float smooth_factor = 0.7;     // 平滑因子
float smooth_bias = 0;         // 平滑后的偏差值

// 状态机变量
unsigned char turn_mode = 0;       // 0=直线，1=左转，2=右转  
unsigned int turn_counter = 0;       // 转弯计数
unsigned int turn_duration = 1000;        // 转弯持续时间
float turn_speed_forward = 37;            // 转弯时的速度
float turn_speed_backward = 0;            // 转弯时的速度(向前)

// *** 新增：转弯分阶段控制变量 ***
unsigned char turn_phase = 0;        // 转弯阶段 0=刹车停止，1=转弯，2=转弯后停止
unsigned int brake_duration = 15;     // 刹车持续时间

//转弯时间补偿
float initial_bias_before_turn = 0;      // 记录转弯前偏差
unsigned int time_compensation = 0;       // 转弯时间补偿值
float bias_threshold = 15.0;               // 补偿触发阈值
unsigned int compensation_time = 25;      // 时间补偿量（约10%的350）

// *** 新增：智能转弯退出机制 ***
unsigned int m0_detect_count = 0;        // M0连续检测计数器
unsigned int turn_check_threshold = 200; // 开始检测M0的计数阈值

// 转弯冷却逻辑
unsigned int turn_cooldown = 0;          // 转弯冷却计数器
unsigned int cooldown_duration = 500;    // 冷却时间（约3s，200Hz循环）

// *** 新增：丢线检测相关变量 ***
unsigned char line_lost = 0;           // 丢线标志
int last_valid_bias = 0;               // 最后一次有效的偏差值

// 全局变量
unsigned char turn_completed_flag = 0;  // 转弯完成标志，用于任务管理器计数

// *** 新增：启动转弯相关变量 ***
unsigned char startup_turn_mode = 0;     // 启动转弯标志：0=未启动，1=已启动过
float startup_turn_speed_forward = 43;   // 启动转弯时的前进速度（比正常转弯大）
float startup_turn_speed_backward = 20;   // 启动转弯时的后退速度
unsigned int startup_turn_duration = 800; // 启动转弯持续时间（比正常转弯短一些）

// 辅助函数
int abs_int(int x) {
    return (x < 0) ? -x : x;
}

float abs_float(float x) {
    return (x < 0.0f) ? -x : x;
}

// 平滑滤波函数
void smooth_sensor_bias() {
    // 对sensor_bias进行平滑处理，减少突变
    smooth_bias = smooth_bias * smooth_factor + sensor_bias * (1.0f - smooth_factor);
}

// *** 新增：微分滤波函数 ***
void filter_differential() {
    // 一阶低通滤波器，减少微分项噪声
    diff_filtered = diff_filtered * diff_filter_alpha + diff_raw * (1.0f - diff_filter_alpha);
}

void sensor_read()
{
    // 冷却计数器递减
    if(turn_cooldown > 0) {
        turn_cooldown--;
    }
    
    // 检测转弯信号（只在直线模式下且冷却结束后检测）
    if(L2 == 0 && turn_mode == 0 && turn_cooldown == 0) {  // L2检测到左转弯信号
        initial_bias_before_turn = working_bias;  // 记录转弯前偏差
    
        // *** 修改：根据是否为启动转弯选择不同的参数 ***
        if(startup_turn_mode == 0) {
            // 第一次转弯，使用启动转弯参数
            if(initial_bias_before_turn > bias_threshold) {
                time_compensation = startup_turn_duration;
            } else if(initial_bias_before_turn < -bias_threshold) {
                time_compensation = startup_turn_duration;
            } else {
                time_compensation = startup_turn_duration;
            }
            startup_turn_mode = 1;  // 标记已经启动过
        } else {
            // 后续转弯，使用正常转弯参数
            if(initial_bias_before_turn > bias_threshold) {
                time_compensation = turn_duration;
            } else if(initial_bias_before_turn < -bias_threshold) {
                time_compensation = turn_duration;
            } else {
                time_compensation = turn_duration;
            }
        }
        
        turn_mode = 1;  // 进入左转模式
        turn_phase = 0; // 从刹车阶段开始
        turn_counter = 0;
        m0_detect_count = 0;  // *** 新增：重置M0检测计数器 ***
        I = 0;  // 清零积分项
        smooth_bias = 0;  // 重置平滑值
        diff_filtered = 0;  // 重置微分滤波值
        line_lost = 0;        // 重置丢线状态
        return;
    }
    
    // 直线跟踪：只使用中间三个传感器L1、M0、R1
    unsigned char line_state = (L1 << 2) | (M0 << 1) | R1;
    
    // 丢线检测逻辑
    unsigned char all_sensors = (L2 << 4) | (L1 << 3) | (M0 << 2) | (R1 << 1) | R2;
    
    if(all_sensors == 0) {  // 所有传感器都检测不到线
        line_lost = 1;
        
        // 根据最后已知偏差方向进行强化纠偏
        if(last_valid_bias > 0) {
            // 上次是左偏，现在丢线了，加大右转力度
            sensor_bias = 50;  
        } else if(last_valid_bias < 0) {
            // 上次是右偏，现在丢线了，加大左转力度
            sensor_bias = -50; 
        } 
        // 如果没有历史信息，保持当前sensor_bias不变
        
        return;
    } else {
        // 检测到线了，重置丢线状态
        if(line_lost == 1) {
            line_lost = 0;
            I = 0;  // 重置积分项，避免累积误差
            diff_filtered = 0;  // 重置微分滤波值
        }
    }
    
    // 原有的传感器状态处理逻辑保持不变
    switch(line_state) {
        case 0b010:  // 010 - 正中央
            sensor_bias = 0;
            last_valid_bias = 0;
            break;
        case 0b110:  // 110 - 车子右偏约10度，需要左转
            sensor_bias = -10;
            last_valid_bias = -10;
            break;
        case 0b011:  // 011 - 车子左偏约10度，需要右转
            sensor_bias = 10;
            last_valid_bias = 10;
            break;
        case 0b100:  // 100 - 车子右偏约20度，需要左转
            sensor_bias = -30;
            last_valid_bias = -30;
            break;
        case 0b001:  // 001 - 车子左偏约20度，需要右转
            sensor_bias = 30;
            last_valid_bias = 30;
            break;
        default:     // 其他情况或丢线，保持上次偏差
            // sensor_bias保持不变
            break;
    }
}

void sensor_pid()
{
    if(turn_mode == 1) {  // 左转模式
        turn_counter++;
        
        if(turn_phase == 0) {  // 刹车停止阶段
            go_backward_a(v_base);  // 左轮反向刹车
            go_backward_b(v_base);  // 右轮反向刹车
            if(turn_counter >= brake_duration) {
                turn_phase = 1;  // 进入转弯阶段
                turn_counter = 0; // 重置计数器
            }
        }
        else if(turn_phase == 1) {  // 转弯执行阶段
            // *** 修改：根据是否为启动转弯选择不同的速度 ***
            if(startup_turn_mode == 1 && g_task_manager.current_turns == 0) {
                // 第一次转弯，使用启动转弯速度
                go_forward_a(startup_turn_speed_forward);     // 右轮前进（更大功率）
                go_forward_b(startup_turn_speed_backward);    // 左轮前进
            } else {
                // 后续转弯，使用正常转弯速度
                go_forward_a(turn_speed_forward);     // 右轮前进
                go_forward_b(turn_speed_backward);    // 左轮前进
            }
						
            // *** 新增：智能转弯退出检测 ***
            if(turn_counter > turn_check_threshold) {  // 转弯200个周期后开始检测
                if(M0 == 0) {  // M0检测到黑线
                    m0_detect_count++;  // 连续检测计数增加
                    if(m0_detect_count >= 5) {  // 连续检测到5次，立即退出转弯
                        // 立即结束转弯，跳到直线模式
                        turn_phase = 2;             // 转弯停止阶段
                        turn_counter = 0;
                        turn_cooldown = cooldown_duration;
                        I = 0;                    
                        smooth_bias = 0;
                        diff_filtered = 0;        
										  	working_bias = 0;
                        sensor_bias = 0;          
                        sensor_bias_last = 0;     
                        initial_bias_before_turn = 0;
                        time_compensation = 0;
                        m0_detect_count = 0;        // 重置M0计数器
                        return;  // 立即退出，不再执行后续转弯逻辑
                    }
                } else {
                    m0_detect_count = 0;  // M0没检测到黑线，重置计数器
                }
            }
            
            // 原有的转弯时间判断（作为备用退出机制）
            if(turn_counter >= time_compensation) {
                turn_phase = 2;  // 进入转弯后停止阶段
                turn_counter = 0; // 重置计数器
            }
        }
        else if(turn_phase == 2) {  // 转弯后停止阶段
            go_backward_a(120);  // 左轮反向刹车
//				  	go_forward_b(turn_speed_backward);  // 右轮反向刹车
            if(turn_counter >= brake_duration) {
                // 转弯完成，回到直线模式
                turn_mode = 0;                   
                turn_phase = 0;                   
                turn_counter = 0;
                turn_cooldown = cooldown_duration;  
                I = 0;                    
                smooth_bias = 0;
                diff_filtered = 0;   
                working_bias = 0;							
                sensor_bias = 0;          
                sensor_bias_last = 0;     
                initial_bias_before_turn = 0;        // 重置偏差记录
                time_compensation = 0;               // 重置时间补偿
                m0_detect_count = 0;                 // *** 新增：重置M0计数器 ***
                turn_completed_flag = 1;  
            }
        }
        return;
    }
    
    // 直线跟踪模式的PID控制
    // 第一步：平滑处理传感器数据
    if(line_lost == 0) {
        smooth_sensor_bias();
    }
    
    // 第二步：死区控制 - 保持原有逻辑
    working_bias = line_lost ? sensor_bias : smooth_bias;
    
    if(abs_float(working_bias) <= deadzone && line_lost == 0) {
        working_bias = 0;  
        I *= 0.8;          
    }
    
    // *** 修改：改进的PID计算 ***
    
    // 比例项
    float P = working_bias;
    
		// 原有的积分逻辑保持不变
		if(abs_float(sensor_bias) > deadzone) {
				I += working_bias;
		} else {
				I *= 0.9;  // 小偏差时衰减积分
		}

    // 大偏差时不累积积分，但不清零现有积分
    
    // *** 修改：微分项计算和滤波 ***
    diff_raw = working_bias - sensor_bias_last;  // 计算原始微分
    filter_differential();  // 对微分进行滤波
    float D = diff_filtered;  // 使用滤波后的微分值
    
    // 更严格的积分防饱和 - 保持原有逻辑
    if(I > 18) I = 18;        
    if(I < -18) I = -18;
    
    // 死区计数逻辑 - 保持原有逻辑
    static int deadzone_count = 0;
    if(abs_float(sensor_bias) <= deadzone) {
        deadzone_count++;
        if(deadzone_count > 5) {  
            I = 0;                
            deadzone_count = 0;
        }
    } else {
        deadzone_count = 0;
    }
    
    // PID输出
    float PID_value = Kp_sensor * P + Ki_sensor * I + Kd_sensor * D;
    sensor_bias_last = working_bias;  
    
    // 输出限制
    float max_output = line_lost ? 25 : 15;
    if(PID_value > max_output) PID_value = max_output;
    if(PID_value < -max_output) PID_value = -max_output;
    
    // 差速控制 - 保持原有逻辑
    left_v = v_base + PID_value;   // 左轮
    right_v = v_base - PID_value;  // 右轮
    
    // 速度限幅 - 保持原有逻辑
    // 电机速度限幅（0-99，对应PWM占空比范围）
    if(left_v > 99) left_v = 99;
    if(left_v < 0) left_v = 0;
    if(right_v > 99) right_v = 99;
    if(right_v < 0) right_v = 0;
    
    // 电机控制 - 保持原有逻辑
    go_forward_a((int)left_v);
    go_forward_b((int)right_v);
}
