Lingduhm/TI_motor_Gimbal_System/empty_motor_rebuild_divide_OK/ti_msp_dl_config.c

/*
 * Copyright (c) 2023, Texas Instruments Incorporated
 * All rights reserved.
 *
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
 * *  Redistributions of source code must retain the above copyright
 *    notice, this list of conditions and the following disclaimer.
 *
 * *  Redistributions in binary form must reproduce the above copyright
 *    notice, this list of conditions and the following disclaimer in the
 *    documentation and/or other materials provided with the distribution.
 *
 * *  Neither the name of Texas Instruments Incorporated nor the names of
 *    its contributors may be used to endorse or promote products derived
 *    from this software without specific prior written permission.
 *
 * THIS SOFTWARE IS PROVIDED BY THE COPYRIGHT HOLDERS AND CONTRIBUTORS "AS IS"
 * AND ANY EXPRESS OR IMPLIED WARRANTIES, INCLUDING, BUT NOT LIMITED TO,
 * THE IMPLIED WARRANTIES OF MERCHANTABILITY AND FITNESS FOR A PARTICULAR
 * PURPOSE ARE DISCLAIMED. IN NO EVENT SHALL THE COPYRIGHT OWNER OR
 * CONTRIBUTORS BE LIABLE FOR ANY DIRECT, INDIRECT, INCIDENTAL, SPECIAL,
 * EXEMPLARY, OR CONSEQUENTIAL DAMAGES (INCLUDING, BUT NOT LIMITED TO,
 * PROCUREMENT OF SUBSTITUTE GOODS OR SERVICES; LOSS OF USE, DATA, OR PROFITS;
 * OR BUSINESS INTERRUPTION) HOWEVER CAUSED AND ON ANY THEORY OF LIABILITY,
 * WHETHER IN CONTRACT, STRICT LIABILITY, OR TORT (INCLUDING NEGLIGENCE OR
 * OTHERWISE) ARISING IN ANY WAY OUT OF THE USE OF THIS SOFTWARE,
 * EVEN IF ADVISED OF THE POSSIBILITY OF SUCH DAMAGE.
 */

/*
 *  ============ ti_msp_dl_config.c =============
 *  Configured MSPM0 DriverLib module definitions
 *
 *  DO NOT EDIT - This file is generated for the MSPM0G350X
 *  by the SysConfig tool.
 */

#include "ti_msp_dl_config.h"

DL_TimerG_backupConfig gMotor_ABackup;
DL_TimerA_backupConfig gMotor_BBackup;
DL_TimerA_backupConfig gTIMER_0Backup;
DL_SPI_backupConfig gSPIBackup;

/*
 *  ======== SYSCFG_DL_init ========
 *  Perform any initialization needed before using any board APIs
 */
SYSCONFIG_WEAK void SYSCFG_DL_init(void)
{
    SYSCFG_DL_initPower();
    SYSCFG_DL_GPIO_init();
    /* Module-Specific Initializations*/
    SYSCFG_DL_SYSCTL_init();
    SYSCFG_DL_Motor_A_init();
    SYSCFG_DL_Motor_B_init();
    SYSCFG_DL_TIMER_0_init();
    SYSCFG_DL_UART_0_init();
    SYSCFG_DL_SPI_init();
    /* Ensure backup structures have no valid state */
	gMotor_ABackup.backupRdy 	= false;
	gMotor_BBackup.backupRdy 	= false;
	gTIMER_0Backup.backupRdy 	= false;

	gSPIBackup.backupRdy 	= false;

}
/*
 * User should take care to save and restore register configuration in application.
 * See Retention Configuration section for more details.
 */
SYSCONFIG_WEAK bool SYSCFG_DL_saveConfiguration(void)
{
    bool retStatus = true;

	retStatus &= DL_TimerG_saveConfiguration(Motor_A_INST, &gMotor_ABackup);
	retStatus &= DL_TimerA_saveConfiguration(Motor_B_INST, &gMotor_BBackup);
	retStatus &= DL_TimerA_saveConfiguration(TIMER_0_INST, &gTIMER_0Backup);
	retStatus &= DL_SPI_saveConfiguration(SPI_INST, &gSPIBackup);

    return retStatus;
}


SYSCONFIG_WEAK bool SYSCFG_DL_restoreConfiguration(void)
{
    bool retStatus = true;

	retStatus &= DL_TimerG_restoreConfiguration(Motor_A_INST, &gMotor_ABackup, false);
	retStatus &= DL_TimerA_restoreConfiguration(Motor_B_INST, &gMotor_BBackup, false);
	retStatus &= DL_TimerA_restoreConfiguration(TIMER_0_INST, &gTIMER_0Backup, false);
	retStatus &= DL_SPI_restoreConfiguration(SPI_INST, &gSPIBackup);

    return retStatus;
}

SYSCONFIG_WEAK void SYSCFG_DL_initPower(void)
{
    DL_GPIO_reset(GPIOA);
    DL_GPIO_reset(GPIOB);
    DL_TimerG_reset(Motor_A_INST);
    DL_TimerA_reset(Motor_B_INST);
    DL_TimerA_reset(TIMER_0_INST);
    DL_UART_Main_reset(UART_0_INST);
    DL_SPI_reset(SPI_INST);

    DL_GPIO_enablePower(GPIOA);
    DL_GPIO_enablePower(GPIOB);
    DL_TimerG_enablePower(Motor_A_INST);
    DL_TimerA_enablePower(Motor_B_INST);
    DL_TimerA_enablePower(TIMER_0_INST);
    DL_UART_Main_enablePower(UART_0_INST);
    DL_SPI_enablePower(SPI_INST);
    delay_cycles(POWER_STARTUP_DELAY);
}

SYSCONFIG_WEAK void SYSCFG_DL_GPIO_init(void)
{

    DL_GPIO_initPeripheralOutputFunction(GPIO_Motor_A_C0_IOMUX,GPIO_Motor_A_C0_IOMUX_FUNC);
    DL_GPIO_enableOutput(GPIO_Motor_A_C0_PORT, GPIO_Motor_A_C0_PIN);
    DL_GPIO_initPeripheralOutputFunction(GPIO_Motor_A_C1_IOMUX,GPIO_Motor_A_C1_IOMUX_FUNC);
    DL_GPIO_enableOutput(GPIO_Motor_A_C1_PORT, GPIO_Motor_A_C1_PIN);
    DL_GPIO_initPeripheralOutputFunction(GPIO_Motor_B_C0_IOMUX,GPIO_Motor_B_C0_IOMUX_FUNC);
    DL_GPIO_enableOutput(GPIO_Motor_B_C0_PORT, GPIO_Motor_B_C0_PIN);
    DL_GPIO_initPeripheralOutputFunction(GPIO_Motor_B_C1_IOMUX,GPIO_Motor_B_C1_IOMUX_FUNC);
    DL_GPIO_enableOutput(GPIO_Motor_B_C1_PORT, GPIO_Motor_B_C1_PIN);

    DL_GPIO_initPeripheralOutputFunction(
        GPIO_UART_0_IOMUX_TX, GPIO_UART_0_IOMUX_TX_FUNC);
    DL_GPIO_initPeripheralInputFunction(
        GPIO_UART_0_IOMUX_RX, GPIO_UART_0_IOMUX_RX_FUNC);

    DL_GPIO_initPeripheralOutputFunction(
        GPIO_SPI_IOMUX_SCLK, GPIO_SPI_IOMUX_SCLK_FUNC);
    DL_GPIO_initPeripheralOutputFunction(
        GPIO_SPI_IOMUX_PICO, GPIO_SPI_IOMUX_PICO_FUNC);
    DL_GPIO_initPeripheralInputFunction(
        GPIO_SPI_IOMUX_POCI, GPIO_SPI_IOMUX_POCI_FUNC);

    DL_GPIO_initDigitalOutputFeatures(LED1_PIN_22_IOMUX,
		 DL_GPIO_INVERSION_DISABLE, DL_GPIO_RESISTOR_PULL_DOWN,
		 DL_GPIO_DRIVE_STRENGTH_LOW, DL_GPIO_HIZ_DISABLE);

    DL_GPIO_initDigitalInputFeatures(M0_PIN_12_IOMUX,
		 DL_GPIO_INVERSION_DISABLE, DL_GPIO_RESISTOR_PULL_DOWN,
		 DL_GPIO_HYSTERESIS_DISABLE, DL_GPIO_WAKEUP_DISABLE);

    DL_GPIO_initDigitalInputFeatures(L1_PIN_23_IOMUX,
		 DL_GPIO_INVERSION_DISABLE, DL_GPIO_RESISTOR_PULL_DOWN,
		 DL_GPIO_HYSTERESIS_DISABLE, DL_GPIO_WAKEUP_DISABLE);

    DL_GPIO_initDigitalInputFeatures(L2_PIN_27_IOMUX,
		 DL_GPIO_INVERSION_DISABLE, DL_GPIO_RESISTOR_PULL_DOWN,
		 DL_GPIO_HYSTERESIS_DISABLE, DL_GPIO_WAKEUP_DISABLE);

    DL_GPIO_initDigitalInputFeatures(R1_PIN_8_IOMUX,
		 DL_GPIO_INVERSION_DISABLE, DL_GPIO_RESISTOR_PULL_DOWN,
		 DL_GPIO_HYSTERESIS_DISABLE, DL_GPIO_WAKEUP_DISABLE);

    DL_GPIO_initDigitalInputFeatures(R2_PIN_6_IOMUX,
		 DL_GPIO_INVERSION_DISABLE, DL_GPIO_RESISTOR_PULL_DOWN,
		 DL_GPIO_HYSTERESIS_DISABLE, DL_GPIO_WAKEUP_DISABLE);

    DL_GPIO_initDigitalInputFeatures(KEY_4_PIN_3_IOMUX,
		 DL_GPIO_INVERSION_DISABLE, DL_GPIO_RESISTOR_PULL_UP,
		 DL_GPIO_HYSTERESIS_DISABLE, DL_GPIO_WAKEUP_DISABLE);

    DL_GPIO_initDigitalInputFeatures(KEY_3_PIN_2_IOMUX,
		 DL_GPIO_INVERSION_DISABLE, DL_GPIO_RESISTOR_PULL_UP,
		 DL_GPIO_HYSTERESIS_DISABLE, DL_GPIO_WAKEUP_DISABLE);

    DL_GPIO_initDigitalInputFeatures(KEY_2_PIN_16_IOMUX,
		 DL_GPIO_INVERSION_DISABLE, DL_GPIO_RESISTOR_PULL_UP,
		 DL_GPIO_HYSTERESIS_DISABLE, DL_GPIO_WAKEUP_DISABLE);

    DL_GPIO_initDigitalInputFeatures(KEY_1_PIN_15_IOMUX,
		 DL_GPIO_INVERSION_DISABLE, DL_GPIO_RESISTOR_PULL_UP,
		 DL_GPIO_HYSTERESIS_DISABLE, DL_GPIO_WAKEUP_DISABLE);

    DL_GPIO_initDigitalInputFeatures(KEY_5_PIN_21_IOMUX,
		 DL_GPIO_INVERSION_DISABLE, DL_GPIO_RESISTOR_PULL_UP,
		 DL_GPIO_HYSTERESIS_DISABLE, DL_GPIO_WAKEUP_DISABLE);

    DL_GPIO_initDigitalOutput(CS_PIN_IOMUX);

    DL_GPIO_initDigitalOutput(I2C_SDA_IOMUX);

    DL_GPIO_initDigitalOutput(I2C_SCL_IOMUX);

    DL_GPIO_setPins(GPIOA, I2C_SDA_PIN |
		I2C_SCL_PIN);
    DL_GPIO_enableOutput(GPIOA, I2C_SDA_PIN |
		I2C_SCL_PIN);
    DL_GPIO_clearPins(GPIOB, LED1_PIN_22_PIN |
		CS_PIN_PIN);
    DL_GPIO_enableOutput(GPIOB, LED1_PIN_22_PIN |
		CS_PIN_PIN);

}



SYSCONFIG_WEAK void SYSCFG_DL_SYSCTL_init(void)
{

	//Low Power Mode is configured to be SLEEP0
    DL_SYSCTL_setBORThreshold(DL_SYSCTL_BOR_THRESHOLD_LEVEL_0);

    
	DL_SYSCTL_setSYSOSCFreq(DL_SYSCTL_SYSOSC_FREQ_BASE);
	/* Set default configuration */
	DL_SYSCTL_disableHFXT();
	DL_SYSCTL_disableSYSPLL();
    DL_SYSCTL_enableMFCLK();

}


/*
 * Timer clock configuration to be sourced by  / 8 (4000000 Hz)
 * timerClkFreq = (timerClkSrc / (timerClkDivRatio * (timerClkPrescale + 1)))
 *   2000000 Hz = 4000000 Hz / (8 * (1 + 1))
 */
static const DL_TimerG_ClockConfig gMotor_AClockConfig = {
    .clockSel = DL_TIMER_CLOCK_BUSCLK,
    .divideRatio = DL_TIMER_CLOCK_DIVIDE_8,
    .prescale = 1U
};

static const DL_TimerG_PWMConfig gMotor_AConfig = {
    .pwmMode = DL_TIMER_PWM_MODE_CENTER_ALIGN,
    .period = 200,
    .isTimerWithFourCC = false,
    .startTimer = DL_TIMER_START,
};

SYSCONFIG_WEAK void SYSCFG_DL_Motor_A_init(void) {

    DL_TimerG_setClockConfig(
        Motor_A_INST, (DL_TimerG_ClockConfig *) &gMotor_AClockConfig);

    DL_TimerG_initPWMMode(
        Motor_A_INST, (DL_TimerG_PWMConfig *) &gMotor_AConfig);

    DL_TimerG_setCaptureCompareOutCtl(Motor_A_INST, DL_TIMER_CC_OCTL_INIT_VAL_LOW,
		DL_TIMER_CC_OCTL_INV_OUT_DISABLED, DL_TIMER_CC_OCTL_SRC_FUNCVAL,
		DL_TIMERG_CAPTURE_COMPARE_0_INDEX);

    DL_TimerG_setCaptCompUpdateMethod(Motor_A_INST, DL_TIMER_CC_UPDATE_METHOD_IMMEDIATE, DL_TIMERG_CAPTURE_COMPARE_0_INDEX);
    DL_TimerG_setCaptureCompareValue(Motor_A_INST, 100, DL_TIMER_CC_0_INDEX);

    DL_TimerG_setCaptureCompareOutCtl(Motor_A_INST, DL_TIMER_CC_OCTL_INIT_VAL_LOW,
		DL_TIMER_CC_OCTL_INV_OUT_DISABLED, DL_TIMER_CC_OCTL_SRC_FUNCVAL,
		DL_TIMERG_CAPTURE_COMPARE_1_INDEX);

    DL_TimerG_setCaptCompUpdateMethod(Motor_A_INST, DL_TIMER_CC_UPDATE_METHOD_IMMEDIATE, DL_TIMERG_CAPTURE_COMPARE_1_INDEX);
    DL_TimerG_setCaptureCompareValue(Motor_A_INST, 100, DL_TIMER_CC_1_INDEX);

    DL_TimerG_enableClock(Motor_A_INST);


    
    DL_TimerG_setCCPDirection(Motor_A_INST , DL_TIMER_CC0_OUTPUT | DL_TIMER_CC1_OUTPUT );


}
/*
 * Timer clock configuration to be sourced by  / 8 (4000000 Hz)
 * timerClkFreq = (timerClkSrc / (timerClkDivRatio * (timerClkPrescale + 1)))
 *   2000000 Hz = 4000000 Hz / (8 * (1 + 1))
 */
static const DL_TimerA_ClockConfig gMotor_BClockConfig = {
    .clockSel = DL_TIMER_CLOCK_BUSCLK,
    .divideRatio = DL_TIMER_CLOCK_DIVIDE_8,
    .prescale = 1U
};

static const DL_TimerA_PWMConfig gMotor_BConfig = {
    .pwmMode = DL_TIMER_PWM_MODE_CENTER_ALIGN,
    .period = 200,
    .isTimerWithFourCC = false,
    .startTimer = DL_TIMER_START,
};

SYSCONFIG_WEAK void SYSCFG_DL_Motor_B_init(void) {

    DL_TimerA_setClockConfig(
        Motor_B_INST, (DL_TimerA_ClockConfig *) &gMotor_BClockConfig);

    DL_TimerA_initPWMMode(
        Motor_B_INST, (DL_TimerA_PWMConfig *) &gMotor_BConfig);

    DL_TimerA_setCaptureCompareOutCtl(Motor_B_INST, DL_TIMER_CC_OCTL_INIT_VAL_LOW,
		DL_TIMER_CC_OCTL_INV_OUT_DISABLED, DL_TIMER_CC_OCTL_SRC_FUNCVAL,
		DL_TIMERA_CAPTURE_COMPARE_0_INDEX);

    DL_TimerA_setCaptCompUpdateMethod(Motor_B_INST, DL_TIMER_CC_UPDATE_METHOD_IMMEDIATE, DL_TIMERA_CAPTURE_COMPARE_0_INDEX);
    DL_TimerA_setCaptureCompareValue(Motor_B_INST, 100, DL_TIMER_CC_0_INDEX);

    DL_TimerA_setCaptureCompareOutCtl(Motor_B_INST, DL_TIMER_CC_OCTL_INIT_VAL_LOW,
		DL_TIMER_CC_OCTL_INV_OUT_DISABLED, DL_TIMER_CC_OCTL_SRC_FUNCVAL,
		DL_TIMERA_CAPTURE_COMPARE_1_INDEX);

    DL_TimerA_setCaptCompUpdateMethod(Motor_B_INST, DL_TIMER_CC_UPDATE_METHOD_IMMEDIATE, DL_TIMERA_CAPTURE_COMPARE_1_INDEX);
    DL_TimerA_setCaptureCompareValue(Motor_B_INST, 100, DL_TIMER_CC_1_INDEX);

    DL_TimerA_enableClock(Motor_B_INST);


    
    DL_TimerA_setCCPDirection(Motor_B_INST , DL_TIMER_CC0_OUTPUT | DL_TIMER_CC1_OUTPUT );


}



/*
 * Timer clock configuration to be sourced by BUSCLK /  (4000000 Hz)
 * timerClkFreq = (timerClkSrc / (timerClkDivRatio * (timerClkPrescale + 1)))
 *   40000 Hz = 4000000 Hz / (8 * (99 + 1))
 */
static const DL_TimerA_ClockConfig gTIMER_0ClockConfig = {
    .clockSel    = DL_TIMER_CLOCK_BUSCLK,
    .divideRatio = DL_TIMER_CLOCK_DIVIDE_8,
    .prescale    = 99U,
};

/*
 * Timer load value (where the counter starts from) is calculated as (timerPeriod * timerClockFreq) - 1
 * TIMER_0_INST_LOAD_VALUE = (5ms * 40000 Hz) - 1
 */
static const DL_TimerA_TimerConfig gTIMER_0TimerConfig = {
    .period     = TIMER_0_INST_LOAD_VALUE,
    .timerMode  = DL_TIMER_TIMER_MODE_PERIODIC,
    .startTimer = DL_TIMER_START,
};

SYSCONFIG_WEAK void SYSCFG_DL_TIMER_0_init(void) {

    DL_TimerA_setClockConfig(TIMER_0_INST,
        (DL_TimerA_ClockConfig *) &gTIMER_0ClockConfig);

    DL_TimerA_initTimerMode(TIMER_0_INST,
        (DL_TimerA_TimerConfig *) &gTIMER_0TimerConfig);
    DL_TimerA_enableInterrupt(TIMER_0_INST , DL_TIMERA_INTERRUPT_ZERO_EVENT);
    DL_TimerA_enableClock(TIMER_0_INST);





}



static const DL_UART_Main_ClockConfig gUART_0ClockConfig = {
    .clockSel    = DL_UART_MAIN_CLOCK_MFCLK,
    .divideRatio = DL_UART_MAIN_CLOCK_DIVIDE_RATIO_1
};

static const DL_UART_Main_Config gUART_0Config = {
    .mode        = DL_UART_MAIN_MODE_NORMAL,
    .direction   = DL_UART_MAIN_DIRECTION_TX_RX,
    .flowControl = DL_UART_MAIN_FLOW_CONTROL_NONE,
    .parity      = DL_UART_MAIN_PARITY_NONE,
    .wordLength  = DL_UART_MAIN_WORD_LENGTH_8_BITS,
    .stopBits    = DL_UART_MAIN_STOP_BITS_ONE
};

SYSCONFIG_WEAK void SYSCFG_DL_UART_0_init(void)
{
    DL_UART_Main_setClockConfig(UART_0_INST, (DL_UART_Main_ClockConfig *) &gUART_0ClockConfig);

    DL_UART_Main_init(UART_0_INST, (DL_UART_Main_Config *) &gUART_0Config);
    /*
     * Configure baud rate by setting oversampling and baud rate divisors.
     *  Target baud rate: 115200
     *  Actual baud rate: 115107.91
     */
    DL_UART_Main_setOversampling(UART_0_INST, DL_UART_OVERSAMPLING_RATE_16X);
    DL_UART_Main_setBaudRateDivisor(UART_0_INST, UART_0_IBRD_4_MHZ_115200_BAUD, UART_0_FBRD_4_MHZ_115200_BAUD);


    /* Configure Interrupts */
    DL_UART_Main_enableInterrupt(UART_0_INST,
                                 DL_UART_MAIN_INTERRUPT_RX);


    DL_UART_Main_enable(UART_0_INST);
}

static const DL_SPI_Config gSPI_config = {
    .mode        = DL_SPI_MODE_CONTROLLER,
    .frameFormat = DL_SPI_FRAME_FORMAT_MOTO3_POL0_PHA0,
    .parity      = DL_SPI_PARITY_NONE,
    .dataSize    = DL_SPI_DATA_SIZE_8,
    .bitOrder    = DL_SPI_BIT_ORDER_MSB_FIRST,
};

static const DL_SPI_ClockConfig gSPI_clockConfig = {
    .clockSel    = DL_SPI_CLOCK_BUSCLK,
    .divideRatio = DL_SPI_CLOCK_DIVIDE_RATIO_1
};

SYSCONFIG_WEAK void SYSCFG_DL_SPI_init(void) {
    DL_SPI_setClockConfig(SPI_INST, (DL_SPI_ClockConfig *) &gSPI_clockConfig);

    DL_SPI_init(SPI_INST, (DL_SPI_Config *) &gSPI_config);

    /* Configure Controller mode */
    /*
     * Set the bit rate clock divider to generate the serial output clock
     *     outputBitRate = (spiInputClock) / ((1 + SCR) * 2)
     *     16000000 = (32000000)/((1 + 0) * 2)
     */
    DL_SPI_setBitRateSerialClockDivider(SPI_INST, 0);
    /* Set RX and TX FIFO threshold levels */
    DL_SPI_setFIFOThreshold(SPI_INST, DL_SPI_RX_FIFO_LEVEL_1_2_FULL, DL_SPI_TX_FIFO_LEVEL_1_2_EMPTY);

    /* Enable module */
    DL_SPI_enable(SPI_INST);
}
