Lingduhm/TI_motor_Gimbal_System/Gimbal/Core/Inc/OLED_Font.h

#ifndef __OLED_FONT_H
#define __OLED_FONT_H

#include "main.h"
const uint8_t HZ[][16*2]=
{
0x00,0x80,0x60,0xF8,0x87,0x80,0x84,0x84,0x84,0xFE,0x82,0x83,0x82,0x80,0x80,0x00,
0x01,0x00,0x00,0xFF,0x00,0x40,0x40,0x40,0x40,0x7F,0x40,0x40,0x40,0x40,0x00,0x00,/*"任",0*/
/* (16 X 16 , 宋体 )*/

0x00,0x00,0x90,0x88,0x4C,0x57,0xA4,0x24,0x54,0x54,0x8C,0x84,0x00,0x00,0x00,0x00,
0x01,0x01,0x80,0x42,0x22,0x1A,0x07,0x02,0x42,0x82,0x42,0x3E,0x01,0x01,0x01,0x00,/*"务",1*/
/* (16 X 16 , 宋体 )*/

0x80,0x80,0x80,0x80,0x80,0x80,0x80,0x80,0x80,0x80,0x80,0x80,0x80,0x80,0x80,0x00,
0x00,0x00,0x00,0x00,0x00,0x00,0x00,0x00,0x00,0x00,0x00,0x00,0x00,0x00,0x00,0x00,/*"一",2*/
/* (16 X 16 , 宋体 )*/

0x00,0x00,0x08,0x08,0x08,0x08,0x08,0x08,0x08,0x08,0x08,0x08,0x08,0x00,0x00,0x00,
0x10,0x10,0x10,0x10,0x10,0x10,0x10,0x10,0x10,0x10,0x10,0x10,0x10,0x10,0x10,0x00,/*"二",3*/
/* (16 X 16 , 宋体 )*/

0x00,0x04,0x84,0x84,0x84,0x84,0x84,0x84,0x84,0x84,0x84,0x84,0x84,0x04,0x00,0x00,
0x20,0x20,0x20,0x20,0x20,0x20,0x20,0x20,0x20,0x20,0x20,0x20,0x20,0x20,0x20,0x00,/*"三",4*/
/* (16 X 16 , 宋体 )*/

0x00,0xFC,0x04,0x04,0x04,0xFC,0x04,0x04,0x04,0xFC,0x04,0x04,0x04,0xFC,0x00,0x00,
0x00,0x7F,0x28,0x24,0x23,0x20,0x20,0x20,0x20,0x21,0x22,0x22,0x22,0x7F,0x00,0x00,/*"四",5*/
/* (16 X 16 , 宋体 )*/

0x40,0x40,0x80,0xF0,0x80,0x40,0x40,0x00,0x00,0x00,0x00,0x00,0x00,0x00,0x00,0x00,
0x02,0x02,0x01,0x0F,0x01,0x02,0x02,0x00,0x00,0x00,0x00,0x00,0x00,0x00,0x00,0x00,/*"*",6*/
/* (8 X 16 , 宋体 )*/

};
/*OLED字模库，宽8像素，高16像素*/
const uint8_t OLED_F8x16[][16]=
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
	
	0x00,0x00,0x00,0x00,0xFF,0x00,0x00,0x00,
	0x00,0x00,0x00,0x00,0xFF,0x00,0x00,0x00,//| 92
	
	0x00,0x02,0x02,0x7C,0x80,0x00,0x00,0x00,
	0x00,0x40,0x40,0x3F,0x00,0x00,0x00,0x00,//} 93
	
	0x00,0x06,0x01,0x01,0x02,0x02,0x04,0x04,
	0x00,0x00,0x00,0x00,0x00,0x00,0x00,0x00,//~ 94
};



#endif
