Lingduhm/TI_motor_Gimbal_System/Gimbal/Core/Inc/OLED.h

#ifndef __OLED_H
#define __OLED_H

#include "main.h"



void OLED_Init(void);
void OLED_Clear(void);
void OLED_I2C_Start(void);
void OLED_I2C_Stop(void);
void OLED_I2C_SendByte(uint8_t Byte);
void OLED_ShowChar(uint8_t Line, uint8_t Column, char Char);
void OLED_ShowString(uint8_t Line, uint8_t Column, char *String);
void OLED_ShowNum(uint8_t Line, uint8_t Column, uint32_t Number, uint8_t Length);
void OLED_ShowSignedNum(uint8_t Line, uint8_t Column, int32_t Number, uint8_t Length);
void OLED_ShowHexNum(uint8_t Line, uint8_t Column, uint32_t Number, uint8_t Length);
void OLED_ShowBinNum(uint8_t Line, uint8_t Column, uint32_t Number, uint8_t Length);
void OLED_DrawBMP(unsigned char x0, unsigned char y0,unsigned char x1, unsigned char y1,unsigned char BMP[]);
void OLED_ShowCHinese(uint8_t Line, uint8_t Column,unsigned char num);
void OLED_SHOW_task(void);

#endif
