Lingduhm/TI_motor_Gimbal_System/empty_motor_rebuild_divide_OK/SPI.h

#ifndef _SPI_H__
#define _SPI_H__

#include "ti_msp_dl_config.h"
#include <stdint.h>

//CS引脚的输出控制
//x=0时输出低电平
//x=1时输出高电平
#define SPI_CS(x)  ( (x) ? DL_GPIO_setPins(CS_PORT,CS_PIN_PIN) : DL_GPIO_clearPins(CS_PORT,CS_PIN_PIN) )

uint16_t W25Q128_readID(void);//读取W25Q128的ID
void W25Q128_write(uint8_t* buffer, uint32_t addr, uint16_t numbyte);      //W25Q128写数据
void W25Q128_read(uint8_t* buffer,uint32_t read_addr,uint16_t read_length);//W25Q128读数据
#endif
