Lingduhm/TI_motor_Gimbal_System/(notices)

Notices in the files:
Gimbal/Core/Inc/main.h:
Copyright (c) 2025 STMicroelectronics.
All rights reserved.
This software is licensed under terms that can be found in the LICENSE file
